icprog/FaboolMiniPcba/README.md

# Fabool Laser Mini PCBA
- Product page: https://www.smartdiys.cc/fabool-laser-mini/
- Shop page: https://shop.smartdiys.cc/collections/desktop-laser-cutter-and-engraver
- Manual page: https://www.smartdiys.cc/manual/fabool-laser-mini/
