icprog/FaboolMiniPcba/LaserMiniBoard BOM_160909.xlsx

Part / Value | Package | Manufacturer | Part No | Circuit Reference | Qty | URL
LD1117 | SOT-223 | STMicroelectronics | LD1117S33TR | U7 | 1 | http://www.digikey.jp/product-detail/ja/stmicroelectronics/LD1117S33TR/497-1242-2-ND/585766
74VHC1GT08 | TSOP-5 | ON Semiconductor | M74VHC1GT08DTT1G | U4 | 1 | http://www.digikey.jp/product-detail/ja/on-semiconductor/M74VHC1GT08DTT1G/M74VHC1GT08DTT1GOSTR-ND/919319
74HC1G00 | TSOP-5 | ON Semiconductor | MC74HC1G00DTT1G | U5 | 1 | http://www.digikey.jp/product-detail/ja/MC74HC1G00DTT1G/MC74HC1G00DTT1GOSCT-ND/1967104
A4982 | 24-TSSOP | Allegro MicroSystems, LLC | A4982SLPTR | U3,U2 | 2 | http://www.digikey.jp/product-detail/ja/allegro-microsystems-llc/A4982SLPTR-T/620-1352-2-ND/2295512
MCP4461 | 20-TSSOP | Microchip Technology | MCP4461-103E/ST | U6 | 1 | http://www.digikey.jp/product-detail/ja/microchip-technology/MCP4461-103E%2FST/MCP4461-103E%2FST-ND/2486262
STM32F205 | 64-LQFP | STMicroelectronics | STM32F205RBT6 | U1 | 1 | http://www.digikey.jp/product-search/ja?keywords=STM32F205RBT6
BSH105,215 | SOT-23 | NXP Semiconductors | BSH105 | TR1 | 1 | http://www.digikey.jp/product-detail/ja/nxp-semiconductors/BSH105,215/568-6215-2-ND/1155056
Tact Switch | DHT-1163S | D.O Electronics Co.,Ltd | DHT-1163S | SW1 | 1 | http://www.seeedstudio.com/depot/images/opl/datasheet/311020029.pdf
DIP Switch | MS-22D18 | DG De Yi Long Electronics Hardware Limited | MS-22D18 G2 | SW2 | 1 | http://www.seeedstudio.com/depot/images/opl/datasheet/3010010P1.pdf
Ferrite bead
220Ω@100MHz, 700mA | 0603 | Laird-Signal Integrity Products | LI0603G221R-10 | L1 | 1 | http://www.digikey.jp/product-detail/ja/LI0603G221R-10/240-2368-1-ND/806728
Crystal
25MHz, 18pF | 5032 | TXC CORPORATION | 7B-25.000MAAJ-T | X1 | 1 | http://www.digikey.jp/product-detail/ja/txc-corporation/7B-25.000MAAJ-T/887-1112-2-ND/2118796
RTC Crystal
32.768KHz, 7pF | 2-SMD | TXC CORPORATION | 9HT10-32.768KDZY-T | X2 | 1 | http://www.digikey.jp/product-detail/ja/txc-corporation/9HT10-32.768KDZY-T/887-1506-2-ND/2690359
LED
2V, 3mA, Red | 0805 | Any | Any | D1,D2,D3,D5 | 4
2V, 3mA, Green | 0805 | Any | Any | D6 | 1
2V, 3mA, Blue | 0805 | Any | Any | D4 | 1
Ceramic Capacitor
10p, Ceramic, 10V, 10% | 0603 | Any | Any | C27,C30 | 2
20p, Ceramic, 10V, 10% | 0603 | Any | Any | C19,C24 | 2
0u1, Ceramic, 10V, 10% | 0603 | Any | Any | C22,C17,C18,C21,C11,C25,C12,C33,C14,C13,C28,C23,C20 | 13
0u22, Ceramic, 10, 10% | 0603 | Any | Any | C1,C2,C10,C9 | 4
2u2, Ceramic, 10V, 10% | 0603 | Any | Any | C15,C16 | 2
1u, Ceramic, 10V, 10% | 0603 | Any | Any | C32 | 1
0u1, Ceramic, 16V, 10% | 0805 | Any | Any | C3,C26,C4,C7,C8 | 5
10u, Ceramic, 10V, 10% | 0805 | Any | Any | C31,C34 | 2
Tantalum Capacitor
10uF, 10V, 20% | 1206 | Any | Any | C29 | 1
Aluminum Capacitor
100u, 35V, 20% | 6.3 x 7.7mm | Any | Any | C5,C6 | 2 | http://www.digikey.jp/product-detail/ja/UWT1V101MCL1GS/493-2203-1-ND/590178
Resistor
0R, 1/10W | 0603 | Any | Any | R6,R5 | 2
22R, 1/10W, 5% | 0603 | Any | Any | R28,R29 | 2
100R, 1/10W, 5% | 0603 | Any | Any | R21 | 1
470R, 1/10W, 5% | 0603 | Any | Any | R31,R17,R16,R15 | 4
1k, 1/10W, 5% | 0603 | Any | Any | R30 | 1
2k7, 1/10W, 5% | 0603 | Any | Any | R20 | 1
4k7, 1/10W, 5% | 0603 | Any | Any | R27,R18,R19 | 3
10k, 1/10W, 5% | 0603 | Any | Any | R2,R4,R23,R22,R24,R25,R14,R12,R13,R11,R26,R32 | 12
100k, 1/10W, 5% | 0603 | Any | Any | R1,R3 | 2
0R1, 1W, 5% | 1206 | Any | Any | R9,R7,R8,R10 | 4
Connector
DC Jack Socket | dia. 2.0 | BEST | DC-005 | J4 | 1 | http://www.seeedstudio.com/depot/images/opl/datasheet/3410020P1.pdf
USB Type B Connector | USB - B | Any | Any | J12 | 1 | http://www.digikey.jp/product-detail/ja/on-shore-technology-inc/USB-B1HSW6/ED2982-ND/2677743
2P Connector |  | JST Sales America Inc | B2B-XH-A(LF)(SN) | J6,J7,J13,J14,J15 | 5
4P Connector |  | JST Sales America Inc | B4B-XH-A(LF)(SN) | J9,J10,J11 | 3
5P Connector |  | JST Sales America Inc | B5B-XH-A(LF)(SN) | J3 | 1
Other
Heat Sink |  | Shenzhen S-mart Electronics Co.,Ltd | Heatsink 8.8*8.8*5mm with 3m thermal conductivity double-sided tape |  | 2
