icprog/FaboolMiniPcba/LaserMiniBoard/LaserMiniBoard.pdf

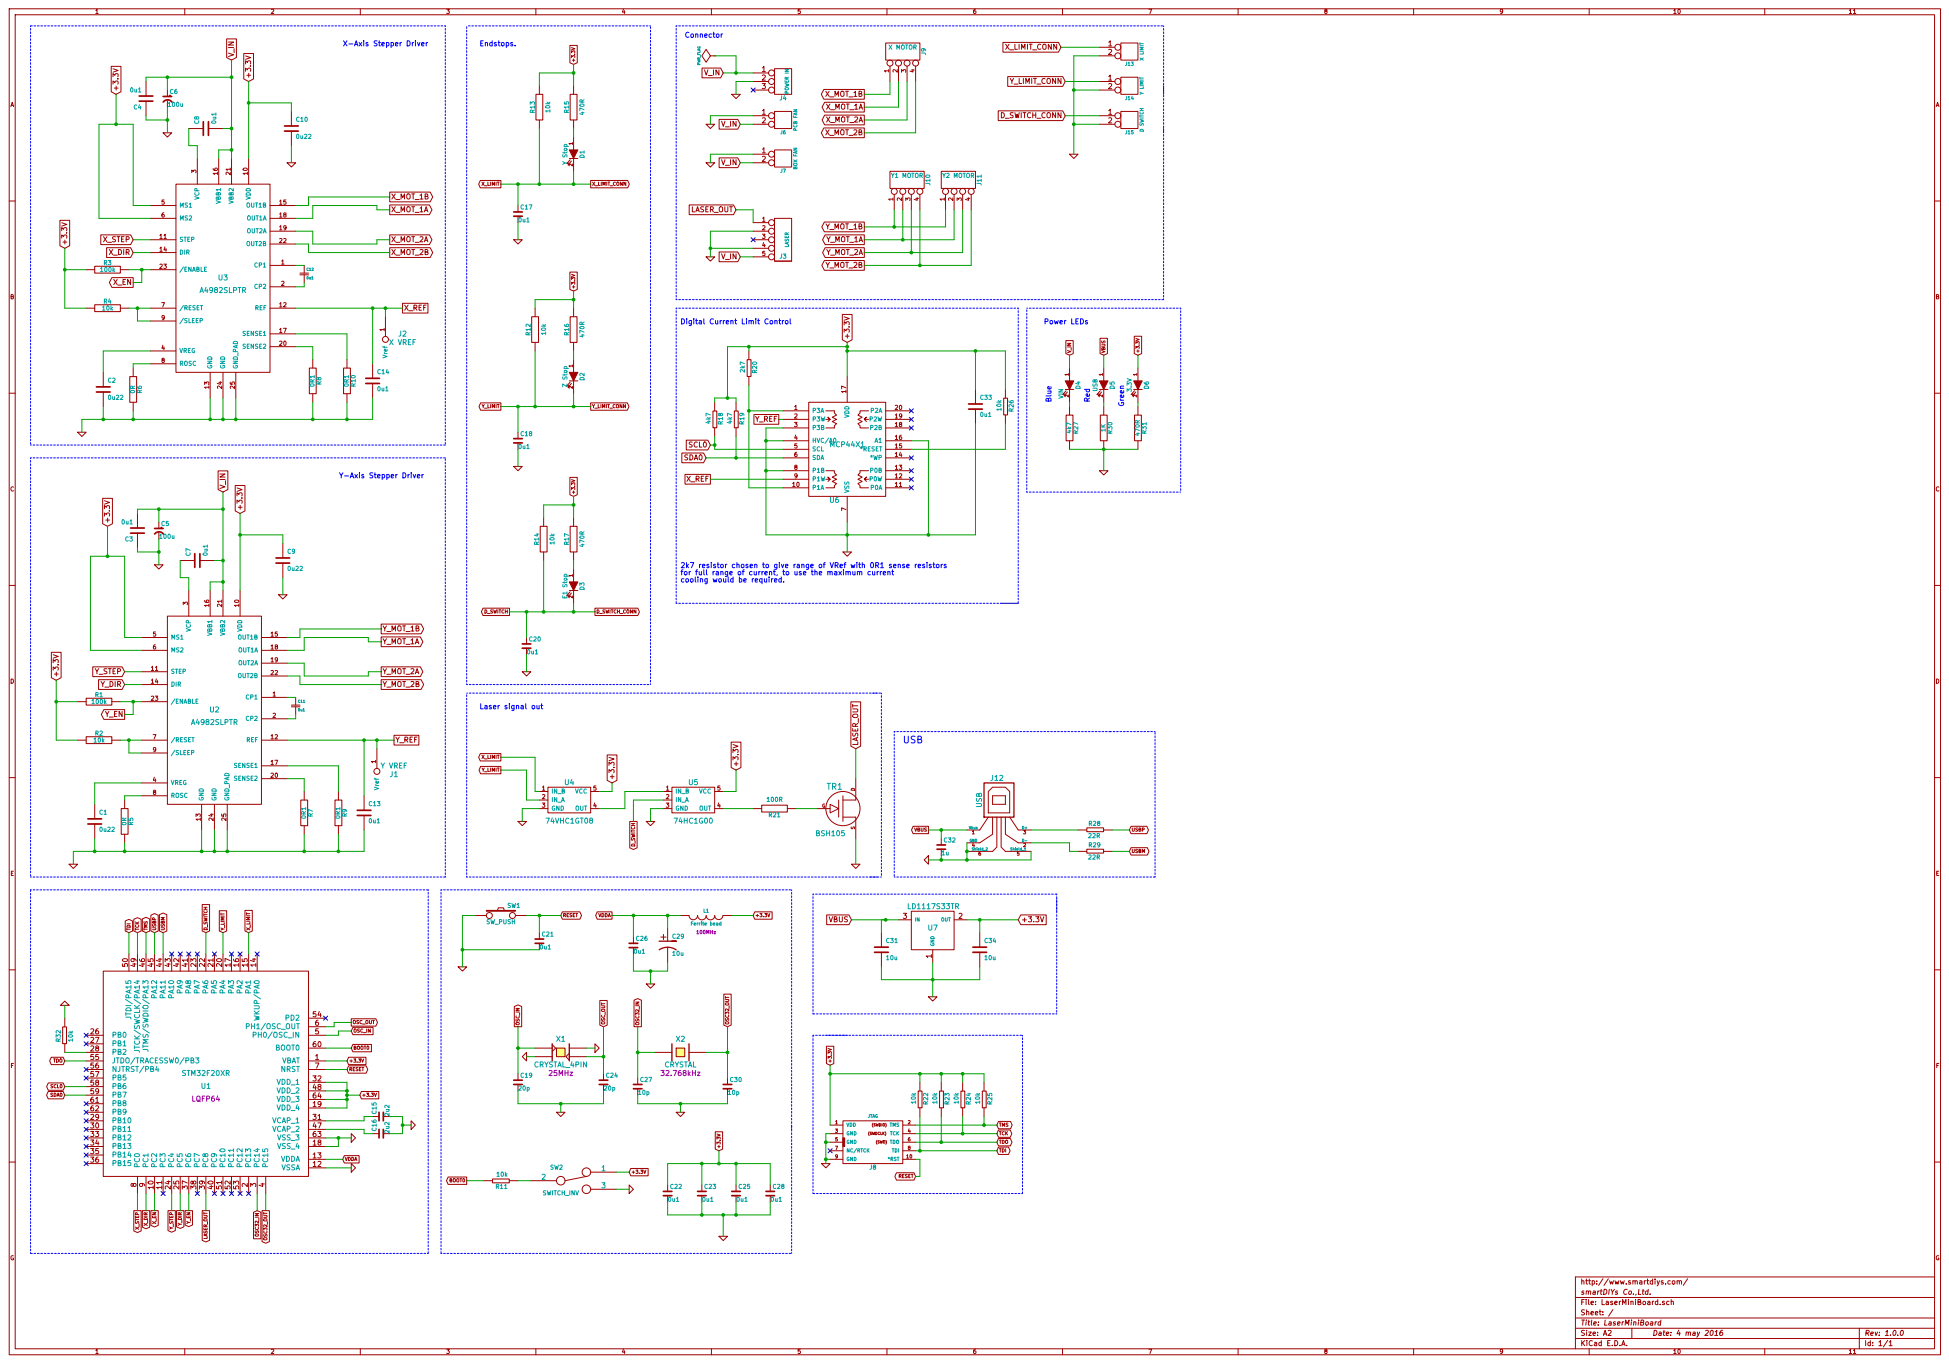
[picture p1: page 1]

Digital Current Limit Control

2k7 resistor chosen to give range of VRef with 0R1 sense resistors
for full range of current, to use the maximum current

USBP USBM TCK TMS USBP USBM

smartDIYs Co.,Ltd.
Id: 1/1 Title: LaserMiniBoard File: LaserMiniBoard.sch Sheet: /
