icprog/FaboolMiniPcba/(commit log)

2016-08-19 データシート追加
2016-09-09 BOM修正
    [LaserMiniBoard BOM_160803.xlsx, LaserMiniBoard BOM_160909.xlsx]
